Dioxgen/ESP-HMI/Images/10.png

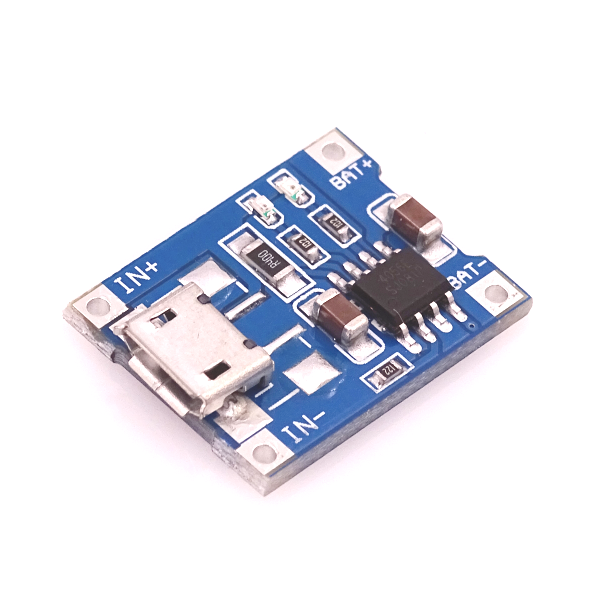
Images/10.png
