Dioxgen/ESP-HMI/Software/SD Card Demo/System/Server/404.md

# 404

###### Error

### Page not found...

<center><b>该页面不存在或正在开发中 DA☆ZE ……</b></center>
