Dioxgen/ESP-HMI/Software/SD Card Demo/System/Server/ESP-HMI.md

# ESP-HMI

欢迎来到ESP-HMI的网络控制端。

### 无线文件传输功能：

> 用户名：当前用户名
>
> 密码：当前用户密码

## [上传文件](/System/Server/upload.html)

## [查看文件](/filelist)
