Dioxgen/ESP-HMI/Software/SD Card Demo/System/Server/success.md

# 文件上传成功！

## [返回](/System/Server/upload.html)
