Dioxgen/ESP-HMI/Hardware/PCB/完成版 Ver 1/2.png

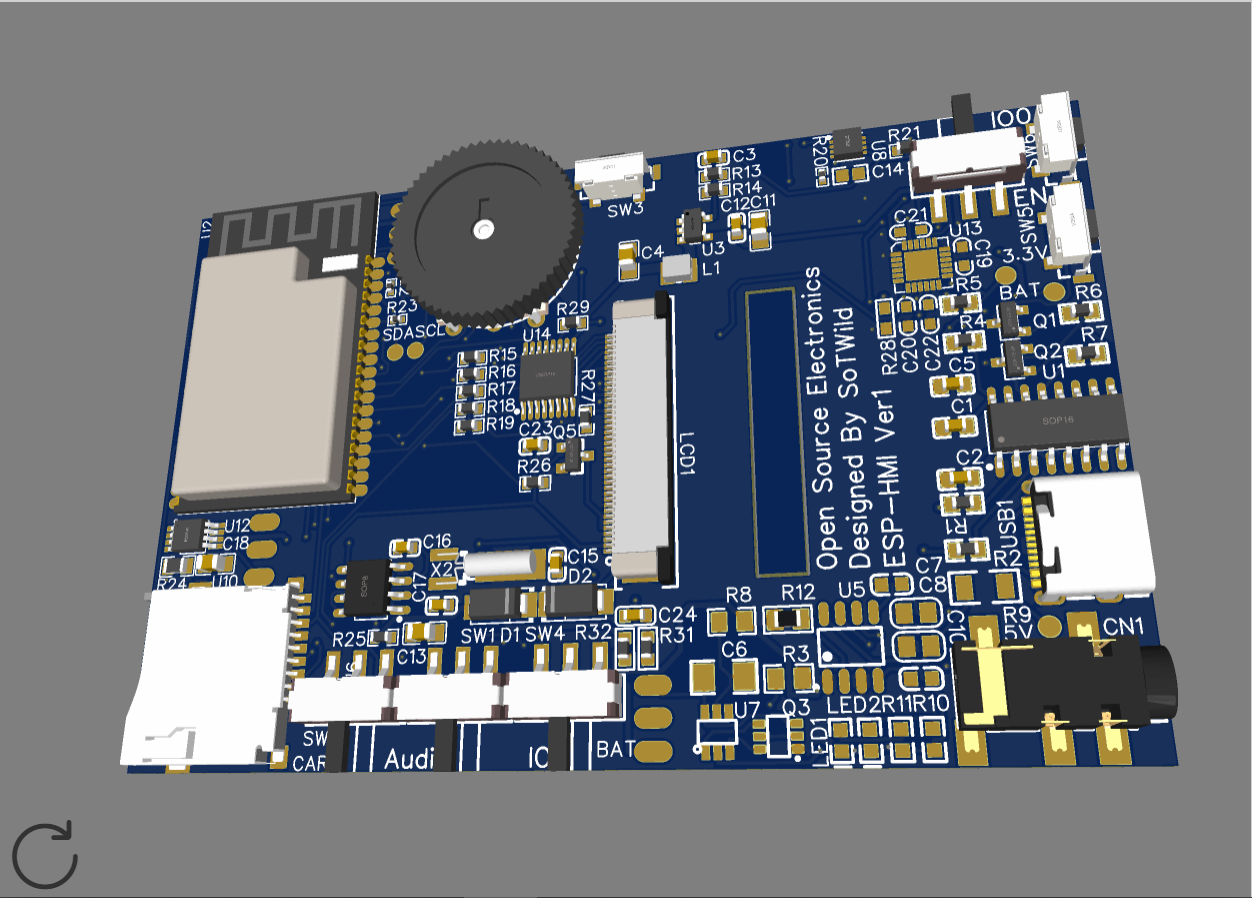
Hardware/PCB/完成版 Ver 1/2.png
