Dioxgen/ESP-HMI/Images/1.png

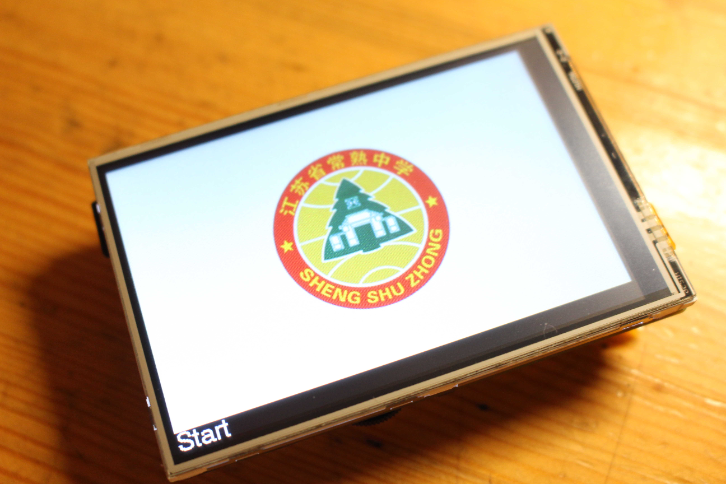
Images/1.png
