Dioxgen/ESP-HMI/Images/2.jpg

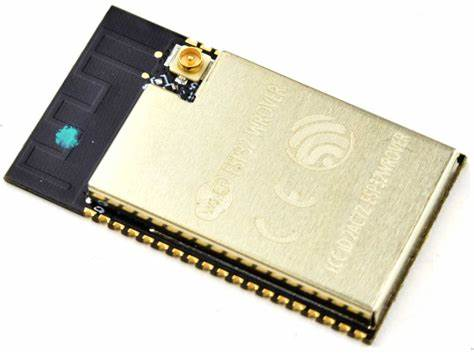
Images/2.jpg
