Dioxgen/ESP-HMI/Images/3.jpg

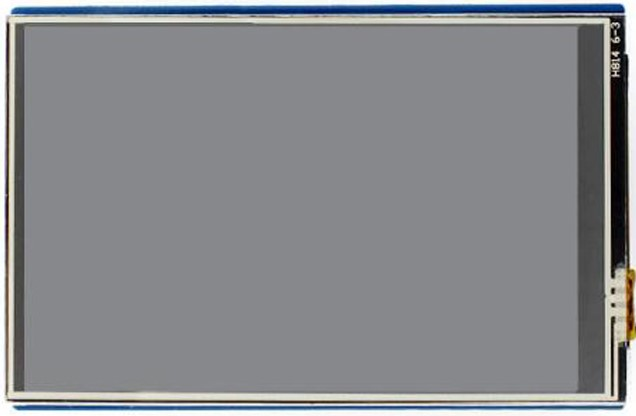
Images/3.jpg
