Dioxgen/ESP-HMI/Images/4.jpg

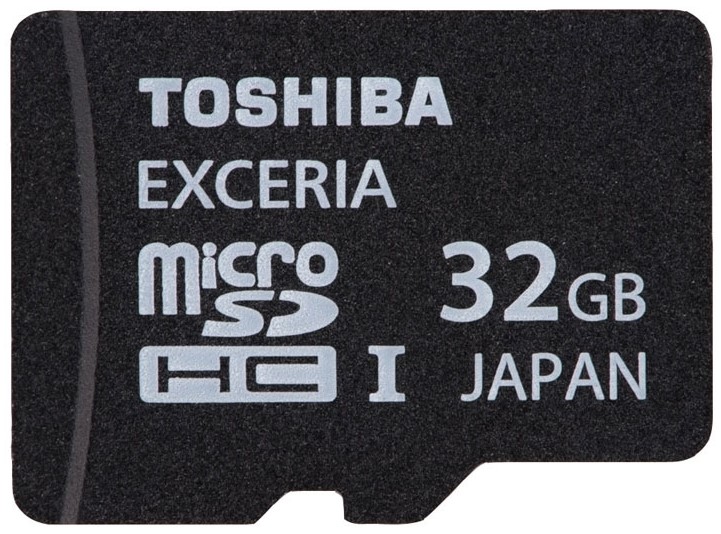
Images/4.jpg
