Dioxgen/ESP-HMI/Images/5.jpg

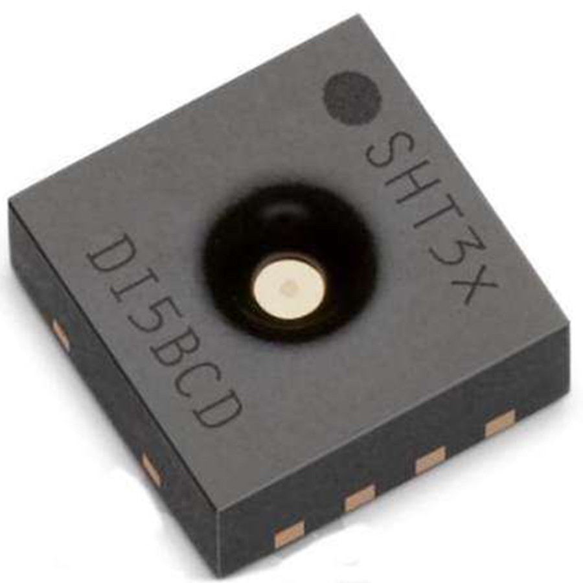
Images/5.jpg
