Dioxgen/ESP-HMI/Images/6.jpg

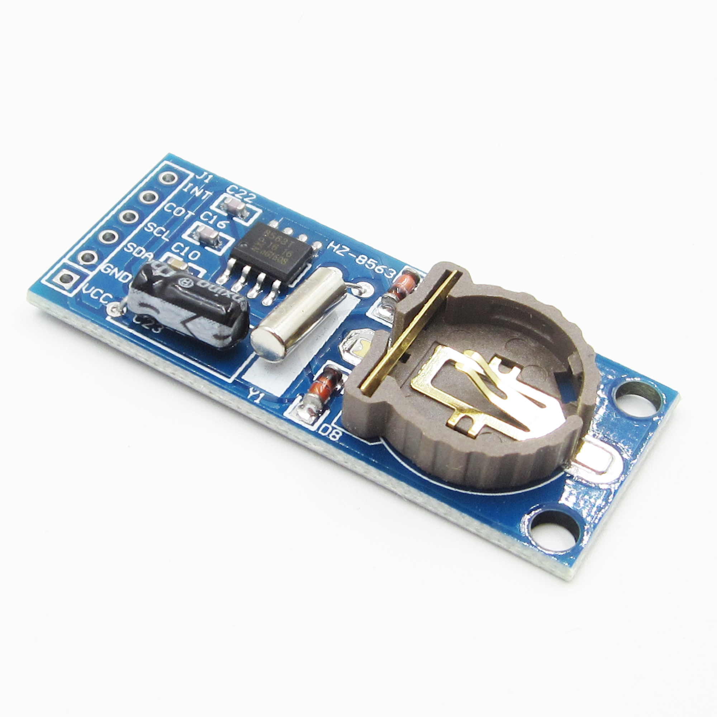
Images/6.jpg
