Dioxgen/ESP-HMI/Images/7.webp

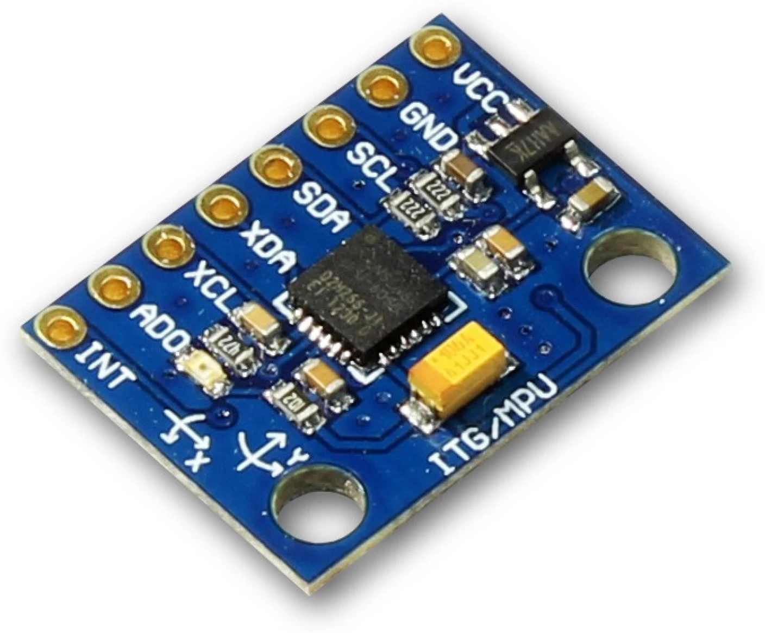
Images/7.webp
