Dioxgen/ESP-HMI/Images/8.jpg

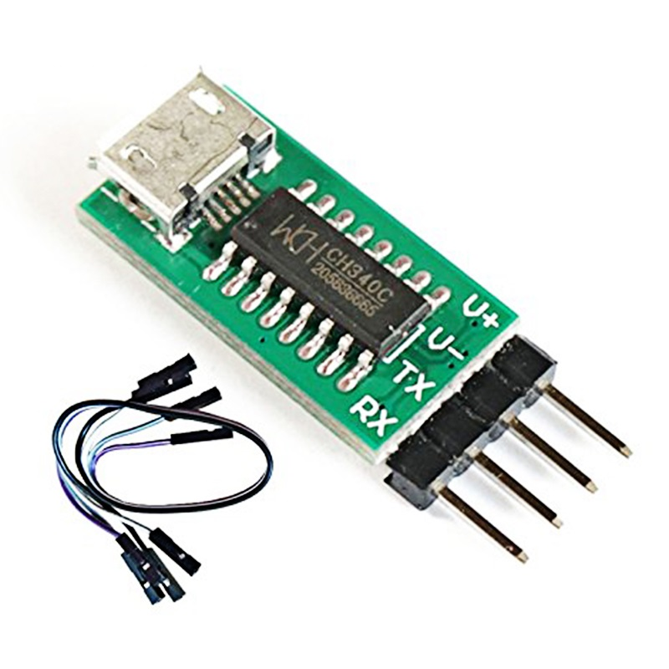
Images/8.jpg
