Dioxgen/ESP-HMI/Images/9.png

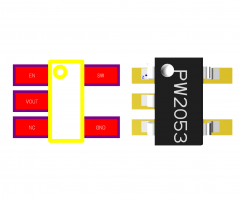
Images/9.png
