Dioxgen/ESP-HMI/Images/11.jpg

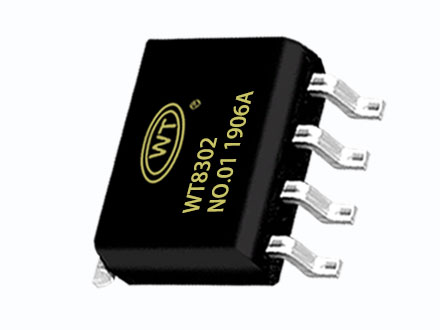
Images/11.jpg
