Dioxgen/ESP-HMI/Images/12.webp

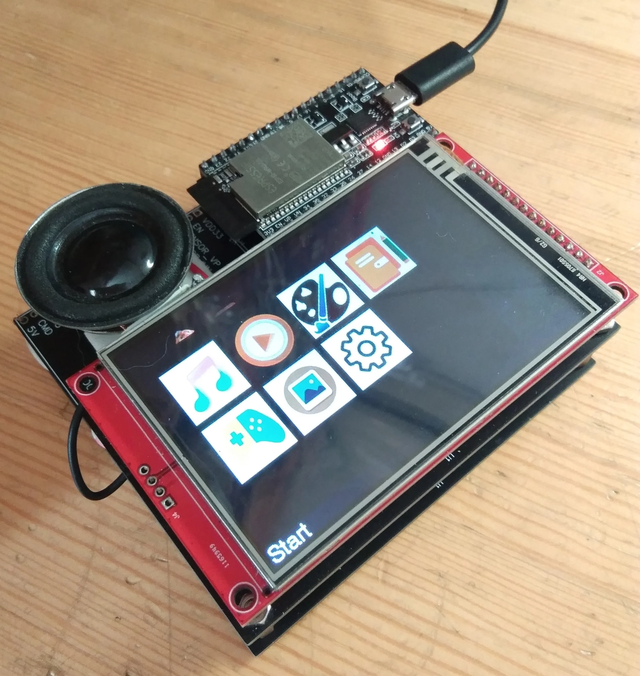
Images/12.webp
