Dioxgen/ESP-HMI/Images/13.webp

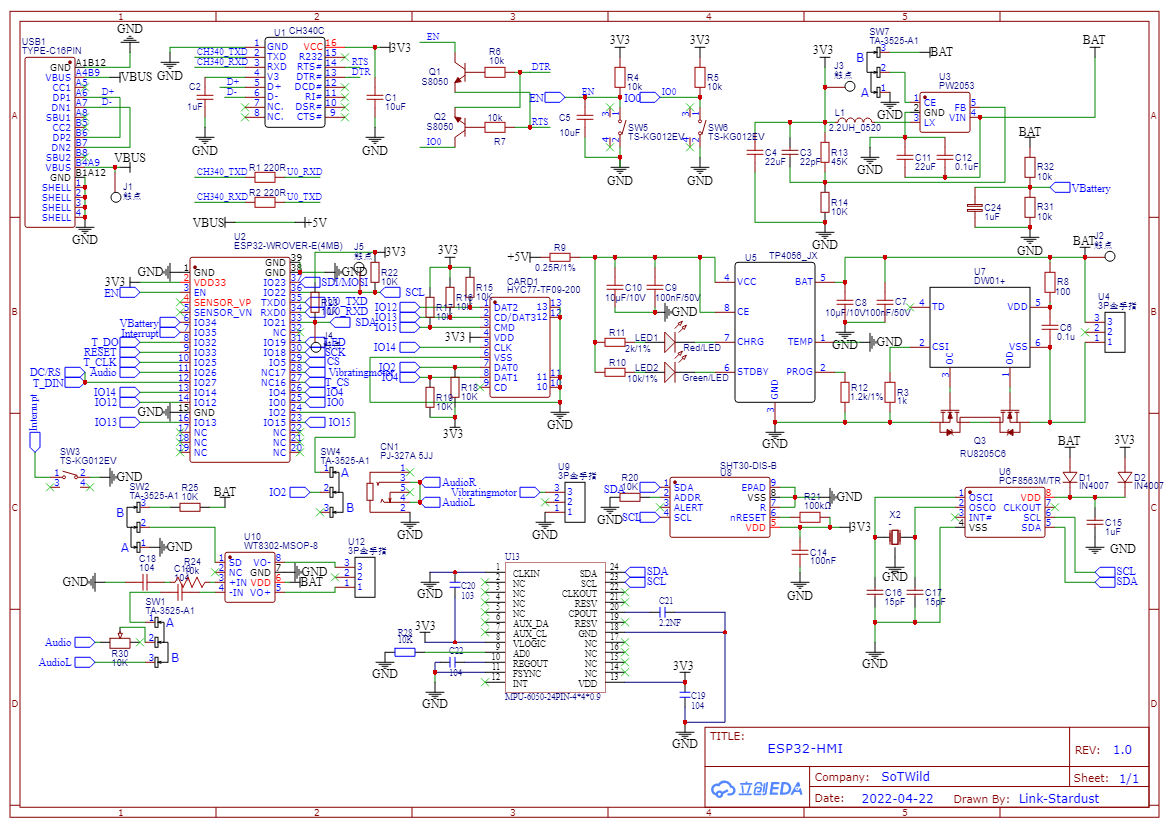
Images/13.webp
