Dioxgen/ESP-HMI/Images/14.webp

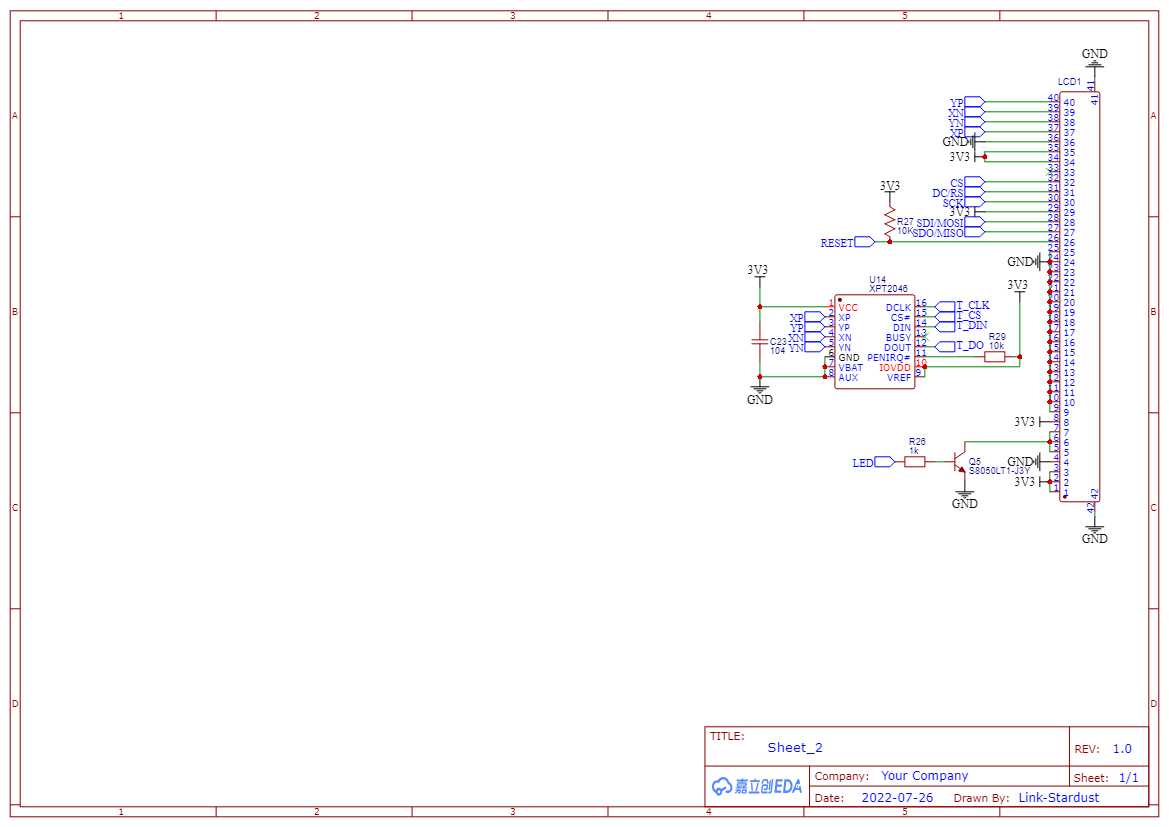
Images/14.webp
