Dioxgen/ESP-HMI/Images/16.png

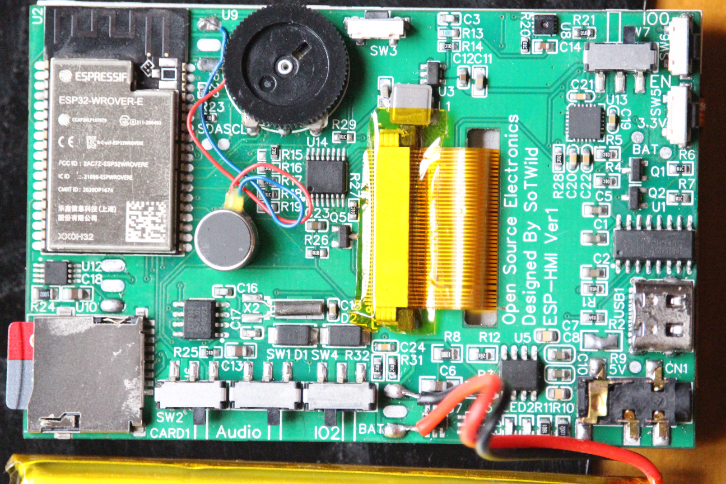
Images/16.png
