Dioxgen/ESP-HMI/Images/17.png

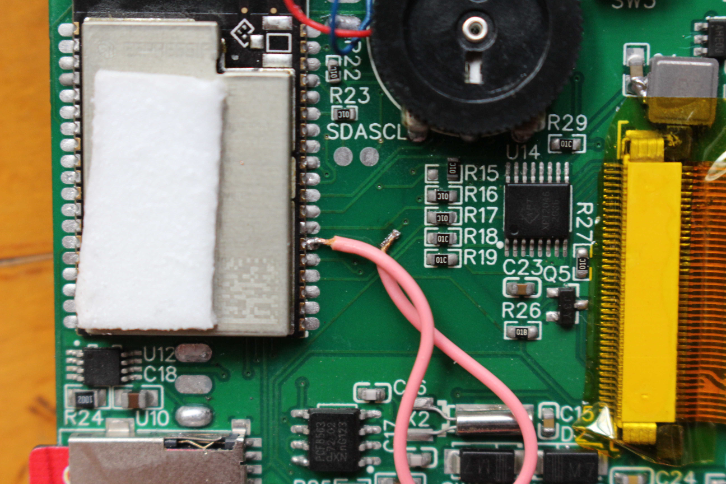
Images/17.png
