Dioxgen/ESP-HMI/Images/18.jpg

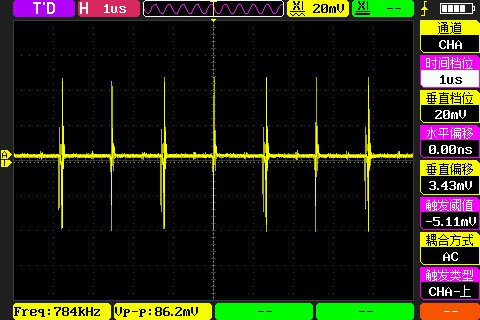
Images/18.jpg
