Dioxgen/ESP-HMI/Images/19.jpg

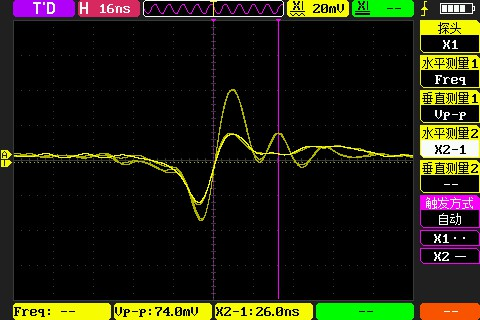
Images/19.jpg
