Dioxgen/ESP-HMI/Images/20.jpg

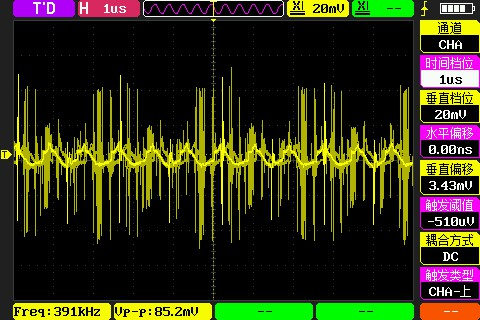
Images/20.jpg
