Dioxgen/ESP-HMI/Images/21.jpg

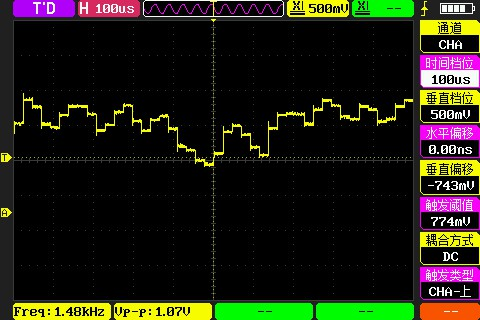
Images/21.jpg
