Dioxgen/ESP-HMI/Images/22.webp

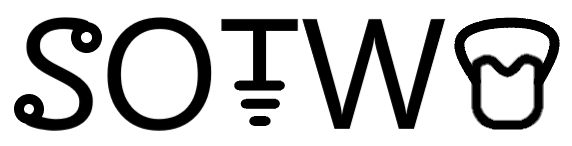
Images/22.webp
