Dioxgen/ESP-HMI/Images/23.jpg

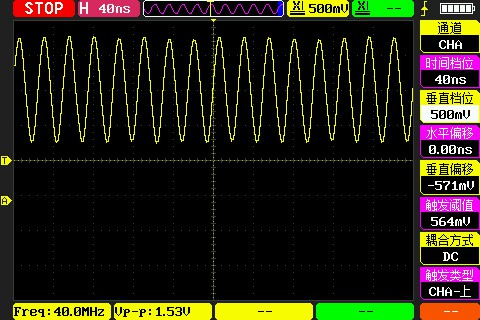
Images/23.jpg
