Dioxgen/ESP-HMI/Images/24.jpg

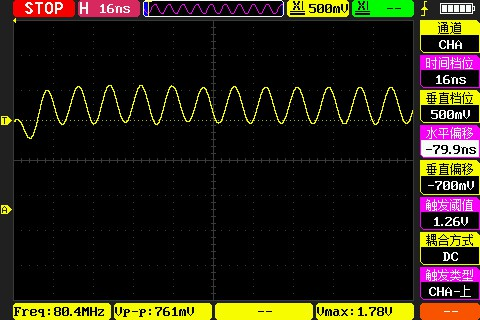
Images/24.jpg
