Dioxgen/ESP-HMI/Images/A.png

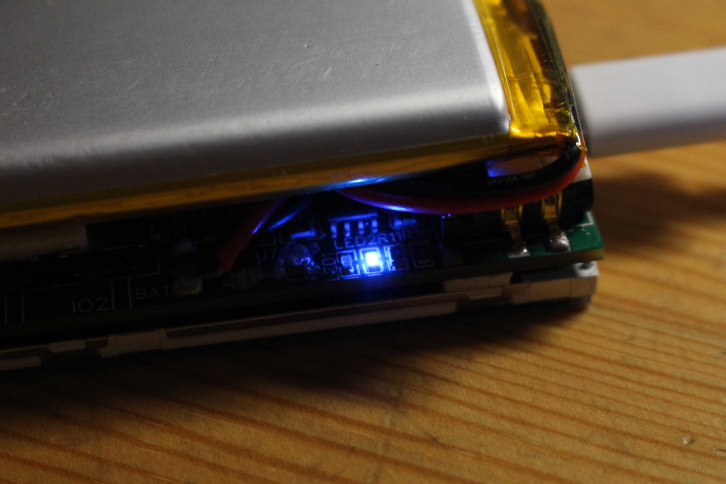
Images/A.png
