Dioxgen/ESP-HMI/Software/SD Card Demo/System/Widgets/Calculator_kb.jpg

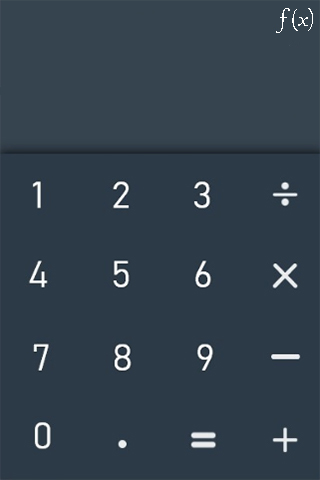
Software/SD Card Demo/System/Widgets/Calculator_kb.jpg
