Dioxgen/ESP-HMI/Software/SD Card Demo/System/Widgets/Coordinate_axis.jpg

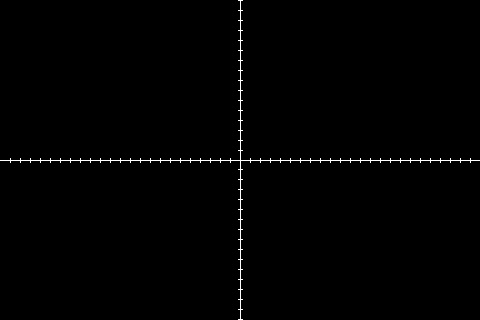
Software/SD Card Demo/System/Widgets/Coordinate_axis.jpg
