Dioxgen/ESP-HMI/Software/SD Card Demo/System/Widgets/signinbkd.jpg

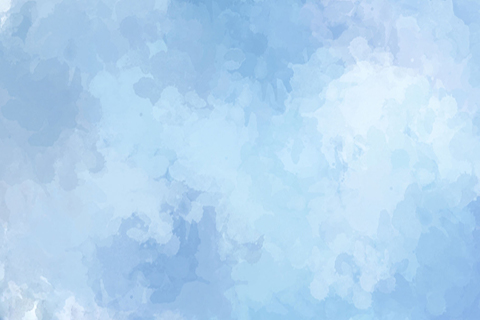
Software/SD Card Demo/System/Widgets/signinbkd.jpg
