Dioxgen/ESP-HMI/Software/SD Card Demo/System/Widgets/user.jpg

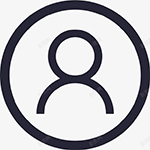
Software/SD Card Demo/System/Widgets/user.jpg
