Dioxgen/ESP-HMI/Hardware/PCB/完成版 Ver 1/BOM_PCB_ESP32-HMI.csv

ID | Name | Designator | Footprint | Quantity | Price | Resistance | Resistance (Ohms) | Tolerance | Value
1 | 10uF | C1,C5 | C0603 | 2
2 | 1uF | C2 | C0603 | 1 | 0.0391
3 | 22pF | C3 | C0603 | 1 | 0.0573
4 | 0.1uF | C12 | C0603 | 1 | 3.29
5 | 1uF | C15 | C0603 | 1 | 0.0351
6 | 15pF | C16,C17 | C0603 | 2 | 0.0883
7 | 22uF | C4,C11 | C0805 | 2 | 3.29
8 | 0.1u | C6 | 1206 | 1
9 | 100nF/50V | C7,C9 | 0603_C_JX | 2
10 | 10μF/10V | C8,C10 | 0805_C_JX | 2
11 | 104 | C13,C18 | C0805 | 2
12 | 100nF | C14 | 603 | 1 | 0.0082 |  |  | ±10% | 100nF
13 | 104 | C19,C22 | C 0603 | 2
14 | 103 | C20 | C 0603 | 1
15 | 2.2NF | C21 | C 0603 | 1
16 | 104 | C23 | C0603 | 1
17 | 1uF | C24 | C0603 | 1 | 0.032
18 | HYC77-TF09-200 | CARD1 | TF-SMD_HYC77-TF09-200 | 1 | 0.9401
19 | PJ-327A 5JJ | CN1 | AUDIO-SMD_PJ-327A5JJ | 1 | 0.5698
20 | IN4007 | D1,D2 | SMA_L4.3-W2.6-LS5.1-RD | 2
21 | 触点 | 5V,BAT,3.3V,SDA,SCL | 触点 | 5
22 | 2.2UH_0520 | L1 | IND-SMD_L2.5-W2.0 | 1
23 | AFC07-S40ECA-00 | LCD1 | FPC-SMD_P0.50-40P_LCS-SJ-H2.0 | 1 | 1.1266
24 | Red/LED | LED1 | 0603_D_JX | 1
25 | Green/LED | LED2 | 0603_D_JX | 1
26 | S8050 | Q1,Q2 | SOT-23-3_L2.9-W1.3-P1.90-LS2.4-BR | 2 | 0.0702
27 | RU8205C6 | Q3 | SOT-23-6 | 1 | 0.3144
28 | S8050LT1-J3Y | Q5 | SOT-23_L2.9-W1.3-P1.90-LS2.4-BR | 1 | 0.1207
29 | 220R | R1,R2 | R0603 | 2
30 | 10k | R4,R5,R6,R7,R29 | R0603 | 5
31 | 1k | R3 | 805 | 1
32 | 100 | R8 | 805 | 1
33 | 0.25R/1% | R9 | 1206_R_JX | 1
34 | 10k/1% | R10 | 0603_R_JX | 1
35 | 2k/1% | R11 | 0603_R_JX | 1
36 | 1.2k/1% | R12 | 0805-R | 1
37 | 45K | R13 | R0603 | 1 | 0.0135 | 45.3kΩ
38 | 10K | R14,R15,R16,R17,R18,R19,R25 | R0603 | 7 | 0.0132 | 10kΩ
39 | 100kΩ | R21 | R0603 | 1 | 0.0075 |  | 100K
40 | 10K | R20,R22,R23 | R0402 | 3 | 0.0038
41 | 10k | R24 | R0805 | 1
42 | 1k | R26 | R0603 | 1
43 | 10K | R27 | R0603 | 1
44 | 10K | R28 | R 0603 | 1
45 | 10K | R30 | RES-ADJ-TH_R1001B | 1 | 0.504
46 | 10k | R31,R32 | R0603 | 2 | 0.0066
47 | TA-3525-A1 | SW1,SW2,SW4,SW7 | SW-SMD_3P-L9.1-W3.5-P2.50-EH6.8 | 4 | 0.8578
48 | TS-KG012EV | SW3,SW5,SW6 | SW-SMD_TS-KG012EV | 3 | 0.3602
49 | CH340C | U1 | SOP-16_L10.0-W3.9-P1.27-LS6.0-BL | 1 | 2.66
50 | ESP32-WROVER-E(4MB) | U2 | WIFIM-SMD_39P-L31.4-W18.0-P1.27 | 1 | 33.11
51 | PW2053 | U3 | SOT-23-5_L2.9-W1.6-P0.95-LS2.8-BL | 1
52 | 3P金手指 | BAT,U9,U12 | 3P金手指 | 3
53 | TP4056_JX | U5 | SOP8_150MIL_JX | 1
54 | PCF8563M/TR | U6 | SOP-8_L4.9-W3.9-P1.27-LS6.0-BL | 1 | 1.1374
55 | DW01+ | U7 | SOT-23-6-L | 1
56 | SHT30-DIS-B | U8 | DFN-8_L2.5-W2.5-P0.50-BL-EP | 1 | 6.48
57 | WT8302-MSOP-8 | U10 | MSOP-8_L3.0-W3.0-P0.65-LS4.9-BL | 1
58 | MPU-6050-24PIN-4*4*0.9 | U13 | QFN24 | 1
59 | XPT2046 | U14 | TSSOP-16_L5.0-W4.4-P0.65-LS6.4-BL | 1 | 3.31
60 | TYPE-C16PIN | USB1 | USB-C-SMD_TYPE-C16PIN | 1 | 1.5593
61 | - | X2 | OSC-SMD_BD2.0-P2.54_TMXLI-206F32.768KHZ12.5PF20PPM | 1 | 1.2412
