Dioxgen/ESP-HMI/Hardware/PCB/直插板/Schematic_ESP32开发直插板.pdf

## ESP32-DEVKITC-VB

## ESP32-DEVKITC-VB

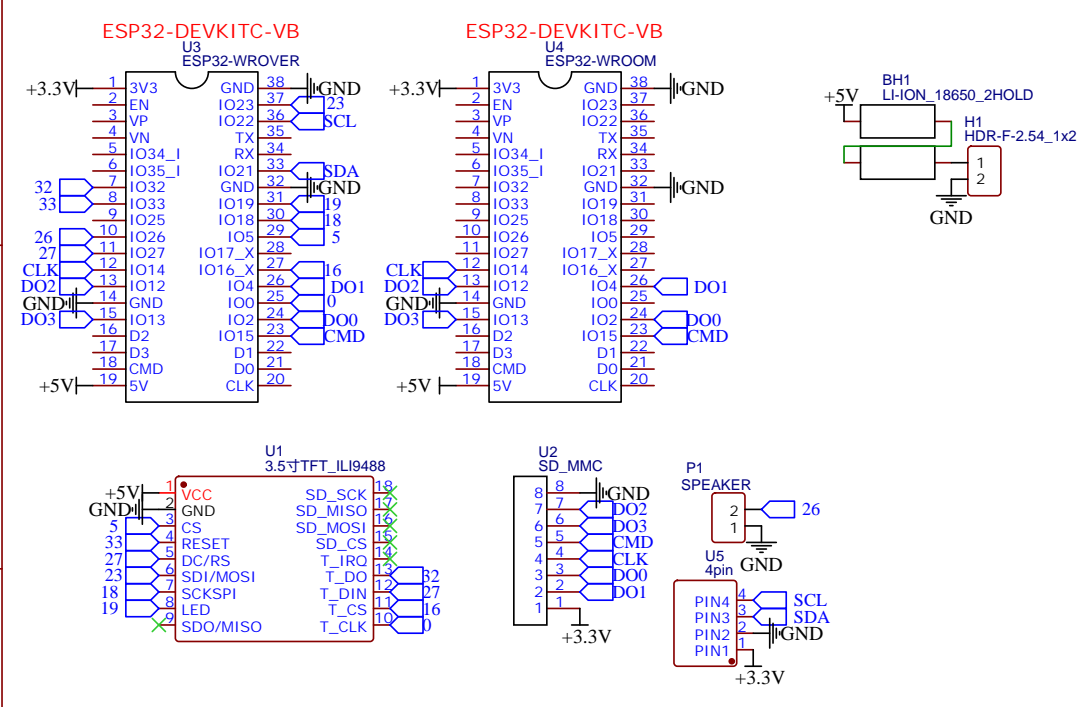
[picture p31: page 1]

Drawn By: Link-Stardust
