Dioxgen/ESP-HMI/Hardware/PCB/完成版 Ver 1/PCB_ESP32-HMI.pdf

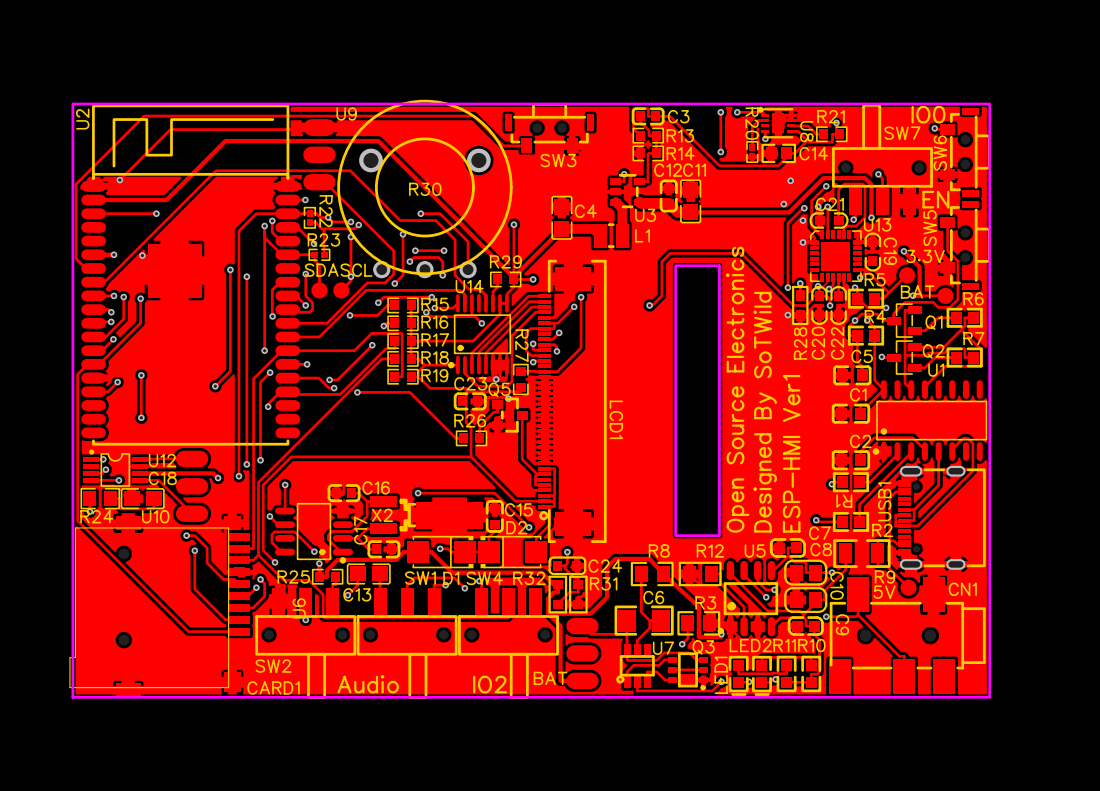
[picture p32: page 1]
