Dioxgen/ESP-HMI/Hardware/PCB/完成版 Ver 1/Schematic_ESP32-HMI.pdf

B

A

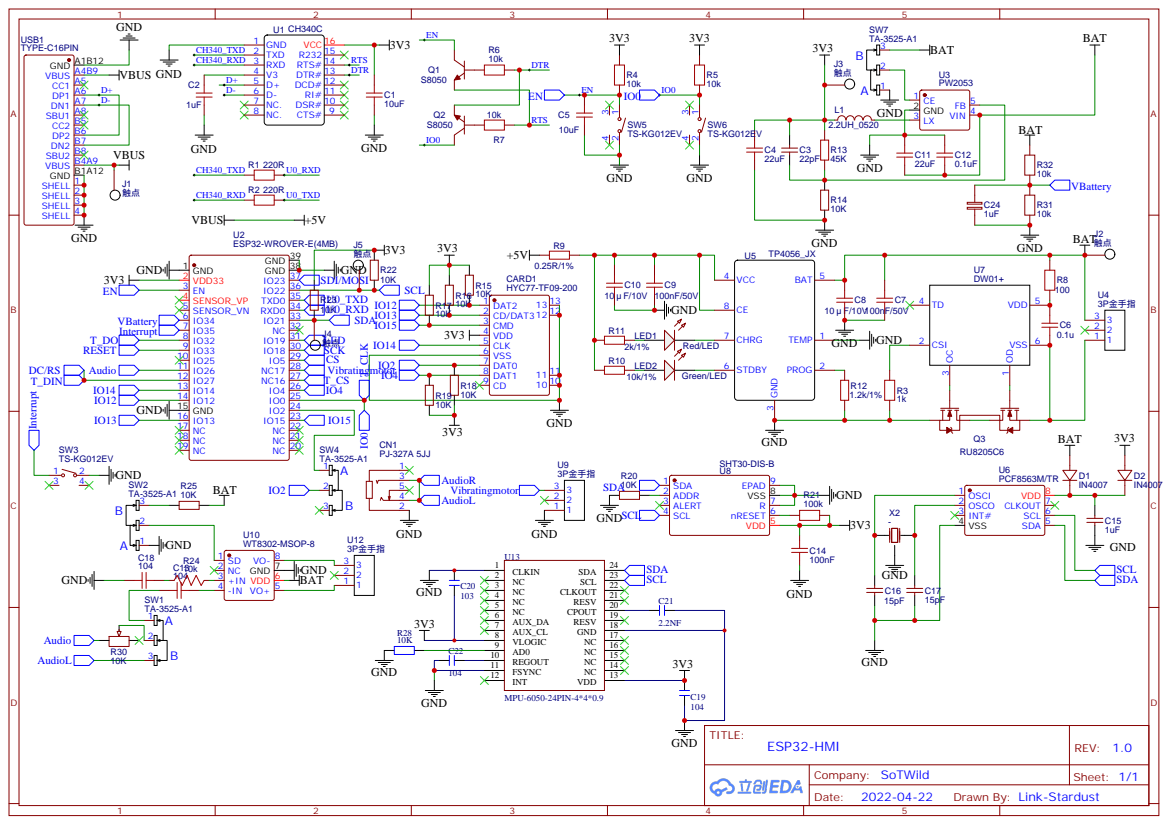
[picture p33: page 1]

Drawn By: Link-Stardust

# LCD1 1

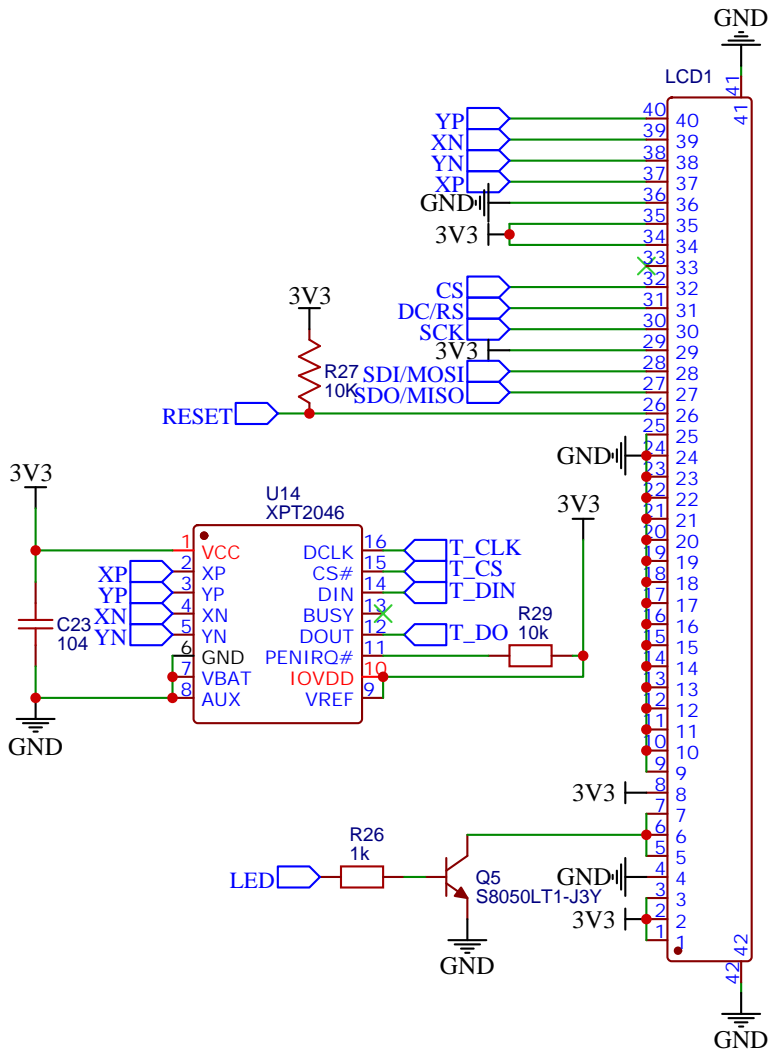
[picture p34: page 2]

Drawn By: Link-Stardust
