Dioxgen/ESP-HMI/Hardware/PCB/直插板/PCB_PCB_ESP32开发直插板.pdf

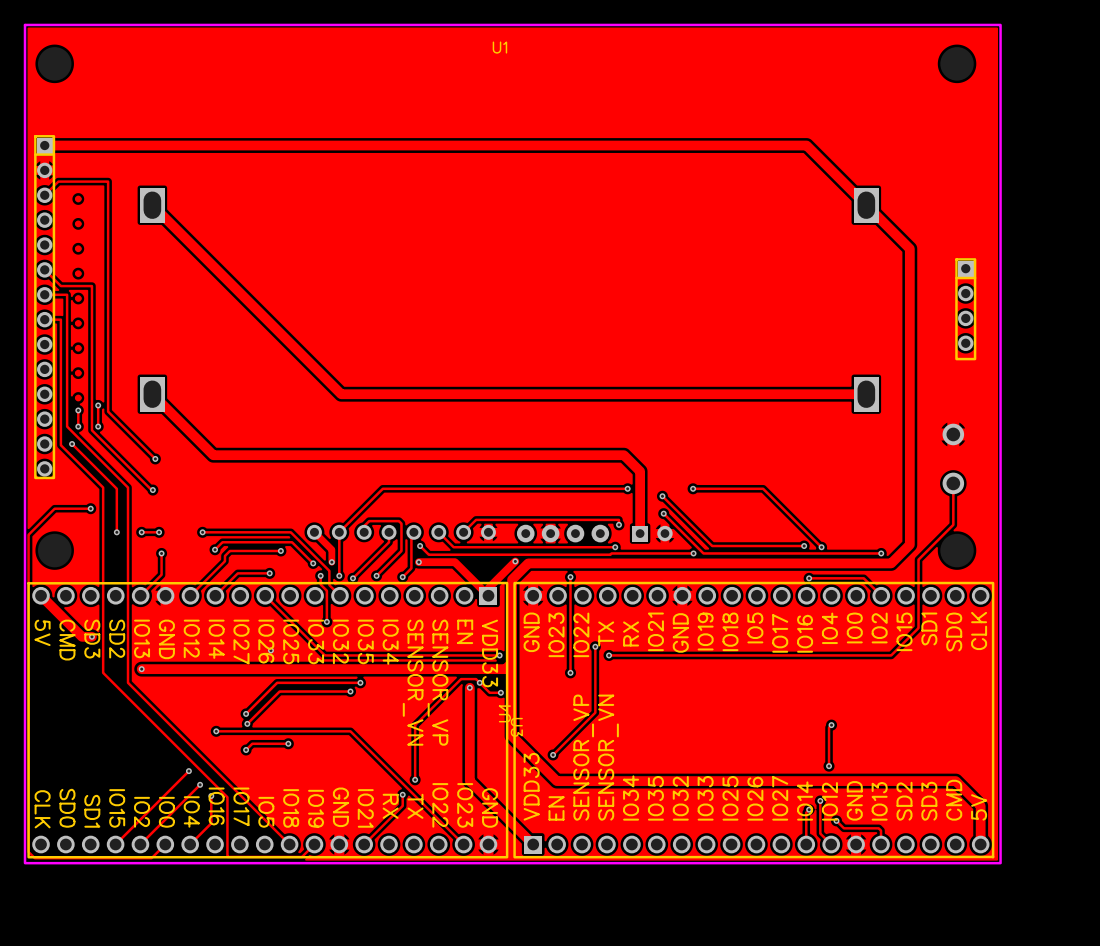
[picture p35: page 1]
