Dioxgen/ESP-HMI/(list of files, drawings)

Other design files:
Hardware/PCB/完成版 Ver 1/PCB_ESP32-HMI.json
Hardware/PCB/完成版 Ver 1/SCH_ESP32-HMI.json
Hardware/PCB/直插板/PCB_PCB_ESP32开发直插板.json
Hardware/PCB/直插板/SCH_ESP32开发直插板.json
