Dioxgen/ESP-HMI/(commit log)

2022-08-14 添加Task Manager 完成Album功能
2022-08-14 README & Images & PCB
    [BOM_PCB_ESP32-HMI.csv, PCB_ESP32-HMI.json, PCB_PCB_ESP32开发直插板.json, SCH_ESP32-HMI.json, SCH_ESP32开发直插板.json]
