Dioxgen/ESP-HMI/(notices)

Notices in the files:
README.md:
License: GPL
